scarv/scarv-soc/src/fsbl/README.md

# First Stage Boot Loader

This is a *very* simple boot rom which will pull a program binary
from a UART port into memory before jumping to it.

## FSBL Assumptions

- That the FSBL runs out of a *read only* memory.

- That the core is set up such that the post-reset PC value points
  at the base address of the memory the FSBL occupies.

- The FSBL program starts at the base address of the memory it
  occupies.

- The FSBL is *position independent*.

## FSBL Procedure

1. Initially the core is in reset.

2. The core is taken out of reset, and the PC is set to the
   base address of the FSBL rom.

3. The FSBL runs, minimally configuring any on-core state as needed.
