scarv/scarv-soc/doc/tex/design-scarv-cpu.tex

The \SCARVCPU is a 5 stage pipelined implementation of the RISC-V
{\tt rv32I} instruction set.
It is extended with the {\bf M}ultiply and {\bf C}ompressed standard
extensions, and the XCrypto non-standard extension for secure and
efficient cryptography.
The source code and documentaiton
for the \SCARVCPU can be found on
GitHub\footnote{\url{https://github.com/scarv/scarv-cpu}}.
