scarv/scarv-soc/doc/scarvsoc.tex

\documentclass{scarv-report}

\usepackage{scarvsoc}

\title{SCARV-SoC\\Technical Report and User Guide}
\date{Version $1.0.0$ (\today)}
\author{Ben Marshall}
\affil{
Department of Computer Science, University of Bristol,\\
Merchant Venturers Building, Woodland Road,\\
Bristol, BS8 1UB, United Kingdom.\\
\url{{ben.marshall}@bristol.ac.uk}
}

\begin{document}

% =============================================================================

\MKPROLOGUE

% =============================================================================

\section{Introduction}
\label{sec:intro}

\import{./tex/}{intro.tex}

\section{Features}
\label{sec:features}

\import{./tex/}{features.tex}

\section{Project Organisation}
\label{sec:organisation}

\import{./tex/}{organisation.tex}

\section{SoC Design}
\label{sec:design}
\import{./tex/}{design-overview.tex}

\subsection{Memory Map}
\label{sec:design:memory-map}
\import{./tex/}{design-memory-map.tex}

\subsection{SCARV-CPU}
\import{./tex/}{design-scarv-cpu.tex}

\subsection{Local Interconnect}
\label{sec:design:block:local-ic}
\import{./tex/}{design-local-ic.tex}

\subsection{Local Memories}
\import{./tex/}{design-local-mem.tex}

\subsection{AXI Bus Bridge}
\label{sec:design:axi-bridge}
\import{./tex/}{design-axi-bridge.tex}

\subsection{Xilinx Peripherals}
\import{./tex/}{design-xilinx.tex}

\section{Hardware Development Flows}
\label{sec:hw-flows}

\subsection{Getting Started}
\label{sec:flow:getting-started}
\import{./tex/}{flow-getting-started.tex}

\subsection{Make Flow Overview}
\import{./tex/}{flow-make.tex}

\subsection{Verilator Simulation}
\label{sec:flow:verilator}
\import{./tex/}{flow-verilator.tex}

\subsection{Symbiyosys Formal Verification Flow}
\import{./tex/}{flow-symbiyosys.tex}

\subsection{Yosys Synthesis}
\import{./tex/}{flow-yosys-synth.tex}

\subsection{Xilinx Vivado Project}
\import{./tex/}{flow-xilinx-vivado.tex}

\section{Software Development Guide}
\label{sec:sw-development}

\subsection{Selfchecking Tests}
\import{./tex/}{sw-selfcheck.tex}

\subsection{First Stage Boot Loader}
\label{sec:sw:fsbl}
\import{./tex/}{sw-fsbl.tex}

\subsection{Board Support Package}
\label{sec:sw:bsp}
\import{./tex/}{sw-bsp.tex}

\subsection{Example Programs}
\import{./tex/}{sw-examples.tex}

\subsection{Developing Programs}
\import{./tex/}{sw-development.tex}

\section{Acknowledgements}

This work has been supported in part by EPSRC via grant EP/R012288/1,
under the RISE (\url{http://www.ukrise.org}) programme.

% =============================================================================

\MKEPILOGUE

% =============================================================================

\end{document}
