scarv/scarv-soc/doc/image/soc-block-diagram.png

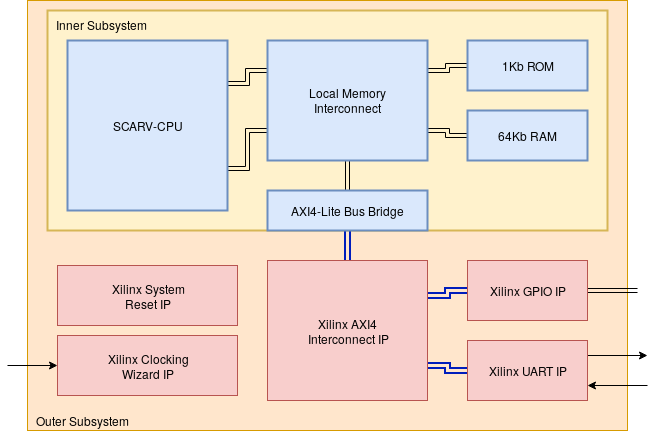
doc/image/soc-block-diagram.png
