scarv/scarv-soc/(threads)

Thread 7 (2019-10-22):

Self Checking Tests

ben-marshall, 2019-10-22:
A small set of sanity/smoke tests for checking things are still working.

Infrastructure:
- [X] Pass/Fail detection

Tests:
- [X] Simple code execution.
- [X] ~~RAM/ROM mixed instruction access.~~
- [x] RAM/ROM mixed data access.
- [x] Data bus error exception handler.
- [x] Instruction bus error exception handler.
- [x] Random number interface.
- [x] External interrupt handler.

Closed 2020-04-14.
