scarv/scarv-soc/rtl/ic/ic_top.v

//
// module: ic_top
//
//  Top level of the simple memory interconnect.
//
module ic_top (

input  wire        g_clk            ,
input  wire        g_resetn         ,

input  wire        cpu_imem_req     , // Start memory request
input  wire        cpu_imem_wen     , // Write enable
input  wire [ 3:0] cpu_imem_strb    , // Write strobe
input  wire [31:0] cpu_imem_wdata   , // Write data
input  wire [31:0] cpu_imem_addr    , // Read/Write address
output wire        cpu_imem_gnt     , // request accepted
output wire        cpu_imem_recv    , // Instruction memory recieve response.
input  wire        cpu_imem_ack     , // Instruction memory ack response.
output wire        cpu_imem_error   , // Error
output wire [31:0] cpu_imem_rdata   , // Read data

input  wire        cpu_dmem_req     , // Start memory request
input  wire        cpu_dmem_wen     , // Write enable
input  wire [ 3:0] cpu_dmem_strb    , // Write strobe
input  wire [31:0] cpu_dmem_wdata   , // Write data
input  wire [31:0] cpu_dmem_addr    , // Read/Write address
output wire        cpu_dmem_gnt     , // request accepted
output wire        cpu_dmem_recv    , // Data memory recieve response.
input  wire        cpu_dmem_ack     , // Data memory ack response.
output wire        cpu_dmem_error   , // Error
output wire [31:0] cpu_dmem_rdata   , // Read data

output wire        rom_imem_req     , // Start memory request
output wire        rom_imem_wen     , // Write enable
output wire [ 3:0] rom_imem_strb    , // Write strobe
output wire [31:0] rom_imem_wdata   , // Write data
output wire [31:0] rom_imem_addr    , // Read/Write address
input  wire        rom_imem_gnt     , // request accepted
input  wire        rom_imem_recv    , // Instruction memory recieve response.
output wire        rom_imem_ack     , // Instruction memory ack response.
input  wire        rom_imem_error   , // Error
input  wire [31:0] rom_imem_rdata   , // Read data

output wire        ram_imem_req     , // Start memory request
output wire        ram_imem_wen     , // Write enable
output wire [ 3:0] ram_imem_strb    , // Write strobe
output wire [31:0] ram_imem_wdata   , // Write data
output wire [31:0] ram_imem_addr    , // Read/Write address
input  wire        ram_imem_gnt     , // request accepted
input  wire        ram_imem_recv    , // Instruction memory recieve response.
output wire        ram_imem_ack     , // Instruction memory ack response.
input  wire        ram_imem_error   , // Error
input  wire [31:0] ram_imem_rdata   , // Read data

output wire        rom_dmem_req     , // Start memory request
output wire        rom_dmem_wen     , // Write enable
output wire [ 3:0] rom_dmem_strb    , // Write strobe
output wire [31:0] rom_dmem_wdata   , // Write data
output wire [31:0] rom_dmem_addr    , // Read/Write address
input  wire        rom_dmem_gnt     , // request accepted
input  wire        rom_dmem_recv    , // Instruction memory recieve response.
output wire        rom_dmem_ack     , // Instruction memory ack response.
input  wire        rom_dmem_error   , // Error
input  wire [31:0] rom_dmem_rdata   , // Read data

output wire        ram_dmem_req     , // Start memory request
output wire        ram_dmem_wen     , // Write enable
output wire [ 3:0] ram_dmem_strb    , // Write strobe
output wire [31:0] ram_dmem_wdata   , // Write data
output wire [31:0] ram_dmem_addr    , // Read/Write address
input  wire        ram_dmem_gnt     , // request accepted
input  wire        ram_dmem_recv    , // Instruction memory recieve response.
output wire        ram_dmem_ack     , // Instruction memory ack response.
input  wire        ram_dmem_error   , // Error
input  wire [31:0] ram_dmem_rdata   , // Read data

output wire        m0_awvalid       , //
input  wire        m0_awready       , //
output wire [31:0] m0_awaddr        , //
output wire [ 2:0] m0_awprot        , //
                                    
output wire        m0_wvalid        , //
input  wire        m0_wready        , //
output wire [31:0] m0_wdata         , //
output wire [ 3:0] m0_wstrb         , //
                                    
input  wire        m0_bvalid        , //
output wire        m0_bready        , //
input  wire [ 1:0] m0_bresp         , //
                                    
output wire        m0_arvalid       , //
input  wire        m0_arready       , //
output wire [31:0] m0_araddr        , //
output wire [ 2:0] m0_arprot        , //
                                    
input  wire        m0_rvalid        , //
output wire        m0_rready        , //
input  wire [ 1:0] m0_rresp         , //
input  wire [31:0] m0_rdata           //

);

//
// Memory map parameters.
// ------------------------------------------------------------

parameter MAP_ROM_MATCH = 32'h1000_0000;
parameter MAP_ROM_MASK  = 32'hFFFF_C000;
parameter MAP_ROM_RANGE = 32'h0000_03FF;

parameter MAP_RAM_MATCH = 32'h2000_0000;
parameter MAP_RAM_MASK  = 32'hFFFF_0000;
parameter MAP_RAM_RANGE = 32'h0000_FFFF;

parameter MAP_AXI_MATCH = 32'h4000_0000;
parameter MAP_AXI_MASK  = 32'hF000_0000;
parameter MAP_AXI_RANGE = 32'h0FFF_FFFF;

//
// Feature Parameters
// ------------------------------------------------------------

// Turn the AXI bridge on (1) or off (0).
parameter ENABLE_AXI_BRIDGE = 1;

//
// Input request address decoding.
// ------------------------------------------------------------

wire ic_imem_error    ; // Address decode error - doesn't map
wire ic_imem_route_rom; // Route to the ROM
wire ic_imem_route_ram; // Route to the RAM
wire ic_imem_route_axi; // Route to the AXI bridge.

wire ic_dmem_error    ; // Address decode error - doesn't map
wire ic_dmem_route_rom; // Route to the ROM
wire ic_dmem_route_ram; // Route to the RAM
wire ic_dmem_route_axi; // Route to the AXI bridge.

//
// Instruction <-> RAM Routing
// ------------------------------------------------------------

assign ram_imem_req   = ic_imem_route_ram && cpu_imem_req;

assign ram_imem_wen   = cpu_imem_wen  ; // Write enable
assign ram_imem_strb  = cpu_imem_strb ; // Write strobe
assign ram_imem_wdata = cpu_imem_wdata; // Write data
assign ram_imem_addr  = cpu_imem_addr ; // Read/Write address

assign ram_imem_ack   = imem_rsp_mask_ram && cpu_imem_ack;

//
// Instruction <-> Error Response
// ------------------------------------------------------------

wire        err_imem_req    = ic_imem_error && cpu_imem_req;

wire        err_imem_gnt    ;
wire        err_imem_recv   ;
wire        err_imem_ack    = imem_rsp_mask_err && cpu_imem_ack;
wire        err_imem_error  ;
wire [31:0] err_imem_rdata  ;

ic_error_rsp_stub i_error_stub_imem (
.g_clk      (g_clk          ),
.g_resetn   (g_resetn       ),
.enable     (err_imem_req   ), // Enable requests / does addr map?
.mem_req    (err_imem_req   ), // Start memory request
.mem_gnt    (err_imem_gnt   ), // request accepted
.mem_wen    ( 1'b0          ), // Write enable
.mem_strb   ( 4'b0          ), // Write strobe
.mem_wdata  (32'b0          ), // Write data
.mem_addr   (32'b0          ), // Read/Write address
.mem_recv   (err_imem_recv  ), // Instruction memory recieve response.
.mem_ack    (err_imem_ack   ), // Instruction memory ack response.
.mem_error  (err_imem_error ), // Error
.mem_rdata  (err_imem_rdata )  // Read data
);

//
// Instruction <-> ROM Routing
// ------------------------------------------------------------

assign rom_imem_req   = ic_imem_route_rom && cpu_imem_req;

assign rom_imem_wen   = cpu_imem_wen  ; // Write enable
assign rom_imem_strb  = cpu_imem_strb ; // Write strobe
assign rom_imem_wdata = cpu_imem_wdata; // Write data
assign rom_imem_addr  = cpu_imem_addr ; // Read/Write address

assign rom_imem_ack   = imem_rsp_mask_rom && cpu_imem_ack;


//
// Data <-> RAM Routing
// ------------------------------------------------------------

assign ram_dmem_req   = ic_dmem_route_ram && cpu_dmem_req;

assign ram_dmem_wen   = cpu_dmem_wen  ; // Write enable
assign ram_dmem_strb  = cpu_dmem_strb ; // Write strobe
assign ram_dmem_wdata = cpu_dmem_wdata; // Write data
assign ram_dmem_addr  = cpu_dmem_addr ; // Read/Write address

assign ram_dmem_ack   = dmem_rsp_mask_ram && cpu_dmem_ack;

//
// Data <-> ROM Routing
// ------------------------------------------------------------

assign rom_dmem_req   = ic_dmem_route_rom && cpu_dmem_req;

assign rom_dmem_wen   = cpu_dmem_wen  ; // Write enable
assign rom_dmem_strb  = cpu_dmem_strb ; // Write strobe
assign rom_dmem_wdata = cpu_dmem_wdata; // Write data
assign rom_dmem_addr  = cpu_dmem_addr ; // Read/Write address

assign rom_dmem_ack   = dmem_rsp_mask_rom && cpu_dmem_ack;

//
// Data <-> AXI
// ------------------------------------------------------------

wire        axi_dmem_req    = ic_dmem_route_axi && cpu_dmem_req;

wire        axi_dmem_gnt    ;
wire        axi_dmem_recv   ;
wire        axi_dmem_ack    = dmem_rsp_mask_axi && cpu_dmem_ack;
wire        axi_dmem_error  ;
wire [31:0] axi_dmem_rdata  ;

generate if(ENABLE_AXI_BRIDGE) begin // ENABLE_AXI_BRIDGE = 1

ic_cpu_bus_axi_bridge i_cpu_dmem_axi_bridge (
.m0_aclk         (g_clk           ), // AXI Clock
.m0_aresetn      (g_resetn        ), // AXI Reset
.m0_awvalid      (m0_awvalid      ), //
.m0_awready      (m0_awready      ), //
.m0_awaddr       (m0_awaddr       ), //
.m0_awprot       (m0_awprot       ), //
.m0_wvalid       (m0_wvalid       ), //
.m0_wready       (m0_wready       ), //
.m0_wdata        (m0_wdata        ), //
.m0_wstrb        (m0_wstrb        ), //
.m0_bvalid       (m0_bvalid       ), //
.m0_bready       (m0_bready       ), //
.m0_bresp        (m0_bresp        ), //
.m0_arvalid      (m0_arvalid      ), //
.m0_arready      (m0_arready      ), //
.m0_araddr       (m0_araddr       ), //
.m0_arprot       (m0_arprot       ), //
.m0_rvalid       (m0_rvalid       ), //
.m0_rready       (m0_rready       ), //
.m0_rresp        (m0_rresp        ), //
.m0_rdata        (m0_rdata        ), //
.enable          (axi_dmem_req    ), // Enable requests / does addr map?
.mem_req         (axi_dmem_req    ), // Start memory request
.mem_gnt         (axi_dmem_gnt    ), // request accepted
.mem_wen         (cpu_dmem_wen    ), // Write enable
.mem_strb        (cpu_dmem_strb   ), // Write strobe
.mem_wdata       (cpu_dmem_wdata  ), // Write data
.mem_addr        (cpu_dmem_addr   ), // Read/Write address
.mem_recv        (axi_dmem_recv   ), // Instruction memory recieve response.
.mem_ack         (axi_dmem_ack    ), // Instruction memory ack response.
.mem_error       (axi_dmem_error  ), // Error
.mem_rdata       (axi_dmem_rdata  )  // Read data
);

end else begin                       // ENABLE_AXI_BRIDGE = 0

// Tie all unused AXI signals to zero.
assign m0_awvalid = 0; //
assign m0_awaddr  = 0; //
assign m0_awprot  = 0; //
assign m0_wvalid  = 0; //
assign m0_wdata   = 0; //
assign m0_wstrb   = 0; //
assign m0_bready  = 0; //
assign m0_arvalid = 0; //
assign m0_araddr  = 0; //
assign m0_arprot  = 0; //
assign m0_rready  = 0; //

ic_error_rsp_stub i_error_stub_axi (
.g_clk      (g_clk          ),
.g_resetn   (g_resetn       ),
.enable     (axi_dmem_req   ), // Enable requests / does addr map?
.mem_req    (axi_dmem_req   ), // Start memory request
.mem_gnt    (axi_dmem_gnt   ), // request accepted
.mem_wen    ( 1'b0          ), // Write enable
.mem_strb   ( 4'b0          ), // Write strobe
.mem_wdata  (32'b0          ), // Write data
.mem_addr   (32'b0          ), // Read/Write address
.mem_recv   (axi_dmem_recv  ), // Instruction memory recieve response.
.mem_ack    (axi_dmem_ack   ), // Instruction memory ack response.
.mem_error  (axi_dmem_error ), // Error
.mem_rdata  (axi_dmem_rdata )  // Read data
);

end endgenerate

//
// Data <-> Error Response
// ------------------------------------------------------------

wire        err_dmem_req    = ic_dmem_error && cpu_dmem_req;

wire        err_dmem_gnt    ;
wire        err_dmem_recv   ;
wire        err_dmem_ack    = dmem_rsp_mask_err && cpu_dmem_ack;
wire        err_dmem_error  ;
wire [31:0] err_dmem_rdata  ;

ic_error_rsp_stub i_error_stub_dmem (
.g_clk      (g_clk          ),
.g_resetn   (g_resetn       ),
.enable     (err_dmem_req   ), // Enable requests / does addr map?
.mem_req    (err_dmem_req   ), // Start memory request
.mem_gnt    (err_dmem_gnt   ), // request accepted
.mem_wen    ( 1'b0          ), // Write enable
.mem_strb   ( 4'b0          ), // Write strobe
.mem_wdata  (32'b0          ), // Write data
.mem_addr   (32'b0          ), // Read/Write address
.mem_recv   (err_dmem_recv  ), // Instruction memory recieve response.
.mem_ack    (err_dmem_ack   ), // Instruction memory ack response.
.mem_error  (err_dmem_error ), // Error
.mem_rdata  (err_dmem_rdata )  // Read data
);

//
// Instruction Response Routing
// ------------------------------------------------------------

assign cpu_imem_recv =
    imem_rsp_mask_rom && rom_imem_recv    ||
    imem_rsp_mask_ram && ram_imem_recv    ||
    imem_rsp_mask_err && err_imem_recv    ;

assign cpu_imem_error=
    imem_rsp_mask_rom && rom_imem_error   ||
    imem_rsp_mask_ram && ram_imem_error   ||
    imem_rsp_mask_err && err_imem_error   ;

assign cpu_imem_rdata=
    {32{imem_rsp_mask_rom}} & rom_imem_rdata   |
    {32{imem_rsp_mask_ram}} & ram_imem_rdata   ;

assign cpu_imem_gnt   = imem_req_ready && (
    ic_imem_route_ram && ram_imem_gnt ||
    ic_imem_route_rom && rom_imem_gnt ||
    ic_imem_error     && err_imem_gnt );

wire [2:0] imem_reqs = {
    rom_imem_req && rom_imem_gnt,
    ram_imem_req && ram_imem_gnt,
    err_imem_req && err_imem_gnt
};

wire [2:0] imem_rsps = {
    rom_imem_recv && cpu_imem_ack,
    ram_imem_recv && cpu_imem_ack,
    err_imem_recv && cpu_imem_ack
};

wire [2:0] imem_rsp_mask;
wire       imem_rsp_mask_rom = imem_rsp_mask[2];
wire       imem_rsp_mask_ram = imem_rsp_mask[1];
wire       imem_rsp_mask_err = imem_rsp_mask[0];
wire       imem_req_ready;

ic_rsp_tracker #(
.ND (3),
.MAX_REQUESTS(3)
) i_ic_rsp_tracker_imem (
.g_clk          (g_clk         ),
.g_resetn       (g_resetn      ),
.requests       (imem_reqs     ),
.responses      (imem_rsps     ),
.response_gnt   (imem_rsp_mask ),
.ready          (imem_req_ready)
);

//
// Data Response Routing
// ------------------------------------------------------------

assign cpu_dmem_recv =
    dmem_rsp_mask_rom  && rom_dmem_recv    ||
    dmem_rsp_mask_ram  && ram_dmem_recv    ||
    dmem_rsp_mask_axi  && axi_dmem_recv    ||
    dmem_rsp_mask_err  && err_dmem_recv    ;

assign cpu_dmem_error=
    dmem_rsp_mask_rom  && rom_dmem_error   ||
    dmem_rsp_mask_ram  && ram_dmem_error   ||
    dmem_rsp_mask_axi  && axi_dmem_error   ||
    dmem_rsp_mask_err  && err_dmem_error   ;

assign cpu_dmem_rdata=
    {32{dmem_rsp_mask_rom}} & rom_dmem_rdata   |
    {32{dmem_rsp_mask_axi}} & axi_dmem_rdata   |
    {32{dmem_rsp_mask_ram}} & ram_dmem_rdata   ;

assign cpu_dmem_gnt   = dmem_req_ready && (
    ic_dmem_route_ram && ram_dmem_gnt ||
    ic_dmem_route_rom && rom_dmem_gnt ||
    ic_dmem_route_axi && axi_dmem_gnt ||
    ic_dmem_error     && err_dmem_gnt );

wire [3:0] dmem_reqs = {
    rom_dmem_req && rom_dmem_gnt,
    ram_dmem_req && ram_dmem_gnt,
    axi_dmem_req && axi_dmem_gnt,
    err_dmem_req && err_dmem_gnt
};

wire [3:0] dmem_rsps = {
    rom_dmem_recv && cpu_dmem_ack,
    ram_dmem_recv && cpu_dmem_ack,
    axi_dmem_recv && cpu_dmem_ack,
    err_dmem_recv && cpu_dmem_ack
};

wire [3:0] dmem_rsp_mask;
wire       dmem_rsp_mask_rom = dmem_rsp_mask[3];
wire       dmem_rsp_mask_ram = dmem_rsp_mask[2];
wire       dmem_rsp_mask_axi = dmem_rsp_mask[1];
wire       dmem_rsp_mask_err = dmem_rsp_mask[0];
wire       dmem_req_ready;

ic_rsp_tracker #(
.ND (4),
.MAX_REQUESTS(3)
) i_ic_rsp_tracker_dmem (
.g_clk          (g_clk         ),
.g_resetn       (g_resetn      ),
.requests       (dmem_reqs     ),
.responses      (dmem_rsps     ),
.response_gnt   (dmem_rsp_mask ),
.ready          (dmem_req_ready)
);

//
// Submodule instances
// ------------------------------------------------------------

// CPU Instruction memory interface address routing.
ic_addr_decode #(
.MAP_ROM_MATCH(MAP_ROM_MATCH),
.MAP_ROM_MASK (MAP_ROM_MASK ),
.MAP_ROM_RANGE(MAP_ROM_RANGE),
.MAP_RAM_MATCH(MAP_RAM_MATCH),
.MAP_RAM_MASK (MAP_RAM_MASK ),
.MAP_RAM_RANGE(MAP_RAM_RANGE),
.MAP_AXI_MATCH(MAP_AXI_MATCH),
.MAP_AXI_MASK (MAP_AXI_MASK ),
.MAP_AXI_RANGE(MAP_AXI_RANGE) 
) ic_addr_decode_cpu_imem (
.g_clk        (g_clk            ),   // Global clock
.g_resetn     (g_resetn         ),   // Synchronous active low reset
.req_valid    (cpu_imem_req     ),   // Request is valid
.req_addr     (cpu_imem_addr    ),   // Request address
.req_dec_err  (ic_imem_error    ),   // Address decode error - doesn't map
.route_rom    (ic_imem_route_rom),   // Route to the ROM
.route_ram    (ic_imem_route_ram),   // Route to the RAM
.route_axi    (ic_imem_route_axi)    // Route to the AXI bridge.
);

// CPU Data memory interface address routing.
ic_addr_decode #(
.MAP_ROM_MATCH(MAP_ROM_MATCH),
.MAP_ROM_MASK (MAP_ROM_MASK ),
.MAP_ROM_RANGE(MAP_ROM_RANGE),
.MAP_RAM_MATCH(MAP_RAM_MATCH),
.MAP_RAM_MASK (MAP_RAM_MASK ),
.MAP_RAM_RANGE(MAP_RAM_RANGE),
.MAP_AXI_MATCH(MAP_AXI_MATCH),
.MAP_AXI_MASK (MAP_AXI_MASK ),
.MAP_AXI_RANGE(MAP_AXI_RANGE) 
) ic_addr_decode_cpu_dmem (
.g_clk        (g_clk            ),   // Global clock
.g_resetn     (g_resetn         ),   // Synchronous active low reset
.req_valid    (cpu_dmem_req     ),   // Request is valid
.req_addr     (cpu_dmem_addr    ),   // Request address
.req_dec_err  (ic_dmem_error    ),   // Address decode error - doesn't map
.route_rom    (ic_dmem_route_rom),   // Route to the ROM
.route_ram    (ic_dmem_route_ram),   // Route to the RAM
.route_axi    (ic_dmem_route_axi)    // Route to the AXI bridge.
);

`ifdef FORMAL_IC_TOP

initial assume(!g_resetn);

always @(posedge g_clk) if(g_resetn && $past(g_resetn)) begin

    assert(!(imem_rsp_mask_err && imem_rsp_mask_rom));

    assert(!(imem_rsp_mask_err && imem_rsp_mask_ram));

    assert(!(imem_rsp_mask_ram && imem_rsp_mask_rom));

    assert(!(dmem_rsp_mask_err && dmem_rsp_mask_rom));

    assert(!(dmem_rsp_mask_err && dmem_rsp_mask_ram));

    assert(!(dmem_rsp_mask_ram && dmem_rsp_mask_rom));
    
    assert(!(dmem_rsp_mask_ram && dmem_rsp_mask_axi));
    
    assert(!(dmem_rsp_mask_err && dmem_rsp_mask_axi));
    
    assert(!(dmem_rsp_mask_rom && dmem_rsp_mask_axi));


    if($past(cpu_imem_recv) && !$past(cpu_imem_ack)) begin
        assert($stable(cpu_imem_recv ));
        assert($stable(cpu_imem_rdata));
        assert($stable(cpu_imem_error));
    end

    if($past(cpu_dmem_recv) && !$past(cpu_dmem_ack)) begin
        assert($stable(cpu_dmem_recv ));
        assert($stable(cpu_dmem_rdata));
        assert($stable(cpu_dmem_error));
    end

end

`endif

endmodule
