scarv/scarv-soc/verif/scarv-soc/memory_bus/memory_device_uart.hpp

#include <cstdlib>
#include <cassert>
#include <cstdio>

#include <iostream>
#include <queue>

#include <unistd.h>
#include <fcntl.h>

#include "memory_device.hpp"

#ifndef MEMORY_DEVICE_UART_HPP
#define MEMORY_DEVICE_UART_HPP

#define MEMORY_DEVICE_UART_RANGE 0x10

/*!
@brief A basic UART device for printing things during simulation.
@details:
Register Map:
Offset  |  Register
--------|----------------------
0x0     | RX
0x4     | TX
0x8     | STATUS
0xC     | CTRL
*/
class memory_device_uart : public memory_device {

public:
    
    memory_device_uart (
        memory_address base
    ) : memory_device(base,MEMORY_DEVICE_UART_RANGE) {

        addr_rx     = addr_base + 0 ;
        addr_tx     = addr_base + 4 ;
        addr_status = addr_base + 8 ;
        addr_ctrl   = addr_base + 12;

        this -> setup_pseudo_terminal();

    }

    ~memory_device_uart(){

        std::cout<<"Closing pseudo terminal"<<std::endl;
        close(pseudo_term_handle);

    }

    /*!
    @brief Read a word from the address given.
    @returns true if the read succeeds. False otherwise.
    */
    bool read_word (
        memory_address addr,
        uint32_t     * dout
    );

    /*!
    @brief Write a single byte to the device.
    @return true if the write is in range, else false.
    */
    bool write_byte (
        memory_address addr,
        uint8_t        data
    );


    /*!
    @brief Return a single byte from the device.
    */
    uint8_t read_byte (
        memory_address addr
    );
    
    int tx_buf_depth  = 16;

protected:
    
    //! Used to provide a virtual serial port.
    int pseudo_term_handle;
    
    //! Did the pseudo terminal open successfully?
    bool pseudo_term_open = false;
    
    //! Name of the slave pseudo terminal.
    char * pseudo_term_slave;
    
    //! Initialises the pseudo terminal.
    void setup_pseudo_terminal();
    
    //! Read any data from the pseudo terminal.
    void poll_pseudo_terminal();

    // Addresses of each register, calculated at instantiation.
    memory_address addr_tx;
    memory_address addr_rx;
    memory_address addr_ctrl;
    memory_address addr_status;
    
    // Contents of each register.
    uint32_t reg_tx;
    uint32_t reg_rx;
    uint32_t reg_ctrl;
    uint32_t reg_status;
    
    //! Stores characters to be read from this device via the TX register.
    std::queue<uint8_t> rx_buffer;

    //! Stores the data to be transmitted in a buffer until a newline is seen.
    std::queue<uint8_t> tx_buffer;

    //! Get the next char from the rx buffer and pop it from the buffer.
    uint8_t get_from_rx_buffer();

    //! Get the next char from the rx buffer and pop it from the buffer.
    void write_to_tx_buffer(uint8_t data);

};

#endif
