scarv/scarv-soc/(commit log)

2019-10-17 Add scarv-cpu submodule
    On branch master
    Your branch is up-to-date with 'origin/master'.
    Changes to be committed:
    new file: .gitmodules
    new file: extern/scarv-cpu
    Changes not staged for commit:
    modified: bin/conf.sh
    modified: doc/soc-design.md
    Untracked files:
    Makefile
    doc/memory-interconnect.md
    flow/
    rtl/
    verif/
    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
2019-10-17 Fix up project workspace script
    Your branch is ahead of 'origin/master' by 1 commit.
    (use "git push" to publish your local commits)
    work/
    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
2019-10-17 Started with very coarse top level RTL.
    Your branch is ahead of 'origin/master' by 3 commits.
    new file: rtl/ic/ic_addr_decode.v
    new file: rtl/ic/ic_cpu_bus_bram_bridge.v
    new file: rtl/ic/ic_cpu_bus_mux.v
    new file: rtl/ic/ic_top.v
    new file: rtl/soc/scarv_soc.v
    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
2019-10-17 Working verilator simulation flow.
    Your branch is ahead of 'origin/master' by 4 commits.
    new file: Makefile
    new file: flow/gtkwave/scarv-soc.gtkw
    new file: flow/verilator/Makefile.in
    new file: flow/verilator/scarv-soc-rtl.manifest
    new file: flow/verilator/scarv-soc-testbench.manifest
    new file: verif/scarv-soc/dut_wrapper.cpp
    new file: verif/scarv-soc/dut_wrapper.hpp
    new file: verif/scarv-soc/main.cpp
    new file: verif/scarv-soc/testbench.cpp
    new file: verif/scarv-soc/testbench.hpp
    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
2019-10-17 Add trimmed down FSBL.
    modified: Makefile
    new file: src/fsbl/Makefile.in
    new file: src/fsbl/README.md
    new file: src/fsbl/boot.S
    new file: src/fsbl/fsbl.c
    new file: src/fsbl/link.ld
    modified: flow/gtkwave/scarv-soc.gtkw
    modified: flow/verilator/Makefile.in
    modified: flow/verilator/scarv-soc-rtl.manifest
    modified: rtl/ic/ic_top.v
    modified: rtl/soc/scarv_soc.v
    rtl/mem/
    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
2019-10-17 Running code out of the ROM
    - Very basic bringup complete.
    - Todo:
    - Routing to RAM
    - Loading of memory into the RAM.
    - Fix awful fetch buffering of the SCARV CPU
    new file: rtl/mem/scarv_soc_bram_single.v
    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
    [ic_top.v, scarv_soc.v]
2019-10-17 Plumbed in instruction RAM.
    - Seems to work jumping from ROM to RAM.
    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
2019-10-17 Put IC response tracking inside own module.
    - makes logc reuse easier.
    new file: rtl/ic/ic_rsp_router.v
    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
2019-10-17 Simple assertions + option to blackbox BRAM read data.
    modified: rtl/ic/ic_addr_decode.v
    modified: rtl/mem/scarv_soc_bram_single.v
    flow/formal/
    verif/formal/
    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
2019-10-17 SymbiYosys files for running designer assertions.
    new file: flow/formal/Makefile.in
    new file: flow/formal/read_sources.tcl
    new file: verif/formal/ic_address_map.sby
    new file: verif/formal/ic_top.sby
    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
2019-10-17 Better proof make flow
2019-10-17 Fix proofs make flow
2019-10-18 Step 1 of integrating data memory interfaces
    modified: doc/memory-interconnect.md
    new file: rtl/mem/scarv_soc_bram_dual.v
    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
2019-10-18 Various tweaks / fixes
    - Fix range of ROM: Should have been 3FF not 3FFF
    - Lengthen default sim time.
    - Play with FSBL
    Your branch is ahead of 'origin/master' by 2 commits.
    modified: flow/formal/Makefile.in
    modified: src/fsbl/boot.S
    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
    [ic_top.v, scarv_soc.v]
2019-10-18 Better / more efficient instruction fetch.
    - Fix bug which caused accidental writes to BRAMs
    - Add request buffering in the CPU BUS/BRAM Bridge modules.
    modified: extern/scarv-cpu
    modified: flow/formal/read_sources.tcl
    modified: rtl/ic/ic_cpu_bus_bram_bridge.v
    modified: rtl/ic/ic_rsp_router.v
    modified: src/fsbl/Makefile.in
    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
    [ic_cpu_bus_bram_bridge.v, ic_top.v, scarv_soc.v]
2019-10-21 Fix cpu mem bus/bram bridge response stalling.
    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
    [ic_cpu_bus_bram_bridge.v]
2019-10-21 Final tweaks for CPU BRAM Bridge
    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
2019-10-21 Re-write CPU bus BRAM bridge module
    - Use FSM to control buffering and draining of stalled requests.
    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
    [ic_cpu_bus_bram_bridge.v]
2019-10-21 Fix missing state transition in BRAM Bus Bridge
    [ic_cpu_bus_bram_bridge.v]
2019-10-22 Change verilator / fsbl dependencies
    - verilator-run-* now depends on the fsbl target.
    - verilator-build does not depend on the fsbl target.
    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
2019-10-22 Add stub error response module for CPU data bus
    - See #9
    - Only added for data bus. Needs some self-checking tests to see if
    it works.
    new file: rtl/ic/ic_error_rsp_stub.v
    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
    [ic_error_rsp_stub.v, ic_top.v]
2019-10-22 Working on IC error response stubs.
    - Synchronous logic works best with a clock signal...
    modified: rtl/ic/ic_error_rsp_stub.v
    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
    [ic_error_rsp_stub.v, ic_top.v]
2019-10-22 Start work on selfchecking tests flow.
    - See #7
    - Can build dedicated bootloader and example test.
    - Need to add pass/fail mechanism to verilator flow.
    - Need to make swapping of memory hex files in/out.
    new file: flow/selfcheck/Makefile.in
    new file: flow/selfcheck/boot-link.ld
    new file: flow/selfcheck/test-link.ld
    new file: verif/selfcheck/bootloader/bootloader.S
    new file: verif/selfcheck/share/selfcheck.S
    new file: verif/selfcheck/share/selfcheck.h
    new file: verif/selfcheck/test_00_example/example.c
    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
2019-10-23 Top level parameters and verilator signal visibility.
    - Make RAM memory file parameter visible and usable.
    - Expose the CPU trace signal interface to verilated environment.
    modified: flow/selfcheck/Makefile.in
    modified: verif/scarv-soc/dut_wrapper.cpp
    modified: verif/scarv-soc/dut_wrapper.hpp
    modified: verif/scarv-soc/main.cpp
    modified: verif/scarv-soc/testbench.cpp
    modified: verif/scarv-soc/testbench.hpp
    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
2019-10-23 Changes to verilated environment
    - Unique verilated file generation for each default ram/rom image.
    - Slow but bullet proof solution.
    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
2019-10-23 Working example selfchecking test.
    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
2019-10-23 Some *very* simple tests for the SoC RAM/ROM
    new file: verif/selfcheck/test_01_simple/simple.c
    new file: verif/selfcheck/test_02_ram_rom_data/main.c
    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
2019-10-23 Add basic data bus error self checking test.
    new file: verif/selfcheck/test_03_data_bus_error/error.S
    new file: verif/selfcheck/test_03_data_bus_error/main.c
    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
    [main.c]
2019-10-23 Better memory map coverage for data bus error test
    [main.c]
2019-10-24 Add checks to data bus error selfcheck test.
    - Make sure that regions which should not produce an error
    don't produce an error.
    modified: verif/selfcheck/test_03_data_bus_error/error.S
    modified: verif/selfcheck/test_03_data_bus_error/main.c
    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
    [main.c]
2019-10-24 Fix ROM address range bug, as picked up by selfcheck test.
    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
    [ic_addr_decode.v]
2019-10-24 Split data error tests
    - Rename data bus error test to data load error
    - New test for data store errors
    renamed: verif/selfcheck/test_03_data_bus_error/error.S -> verif/selfcheck/test_03_data_load_error/error.S
    renamed: verif/selfcheck/test_03_data_bus_error/main.c -> verif/selfcheck/test_03_data_load_error/main.c
    new file: verif/selfcheck/test_04_data_store_error/error.S
    new file: verif/selfcheck/test_04_data_store_error/main.c
    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
    [main.c]
2019-10-24 Add RTL for instruction bus error responses.
    - Add error stub peripheral for instruction memory bus to
    the interconnect.
    modified: verif/selfcheck/test_03_data_load_error/error.S
    modified: verif/selfcheck/test_04_data_store_error/error.S
    verif/selfcheck/test_05_instr_bus_error/
    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
    [ic_top.v]
2019-10-24 Fix trap handlers for selfcheck tests 03/04
    - Make sure they fail gracefully and don't just timeout.
    modified: extern/scarv-cpu (new commits)
    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
2019-10-24 Add instruction bus error test.
    new file: verif/selfcheck/test_05_instr_bus_error/error.S
    new file: verif/selfcheck/test_05_instr_bus_error/main.c
    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
    [main.c]
2019-10-24 Verilator support for a dumb AXI4Lite slave agent.
    - Just responds with the right control flow signals.
    - Doesn't do anything with the data etc.
    modified: flow/verilator/scarv-soc-testbench.manifest
    new file: verif/scarv-soc/axi4lite/a4l_slave_agent.cpp
    new file: verif/scarv-soc/axi4lite/a4l_slave_agent.hpp
    new file: verif/scarv-soc/axi4lite/a4l_txns.hpp
    modified: rtl/ic/ic_cpu_bus_axi_bridge.v
    verif/se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
    [dut_wrapper.cpp, dut_wrapper.hpp]
2019-10-24 Simple test for AXI bus
    - Just hammers it with loads/stores to make sure we don't lock
    up the bus.
    new file: verif/selfcheck/test_06_axi_bridge/main.c
    new file: verif/selfcheck/test_06_axi_bridge/test.S
    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
2019-10-24 Bugfixes to the AXI bridge.
    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
    [ic_cpu_bus_axi_bridge.v]
2019-10-25 RTL and assertion fixes for AXI bus bridge
    modified: verif/formal/ic_cpu_bus_axi_bridge.sby
    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
    [ic_cpu_bus_axi_bridge.v]
2019-10-25 Integrate memory bus model to verilator environment.
    - Added small RAM model at base of AXI address range for
    self checking test.
    - Added UART model at 0x40001000
    Your branch is ahead of 'origin/master' by 5 commits.
    modified: verif/scarv-soc/axi4lite/a4l_slave_agent.cpp
    modified: verif/scarv-soc/axi4lite/a4l_slave_agent.hpp
    new file: verif/scarv-soc/memory_bus/memory_bus.cpp
    new file: verif/scarv-soc/memory_bus/memory_bus.hpp
    new file: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
2019-10-25 Sparse test for the modelled AXI UART.
    modified: verif/selfcheck/share/selfcheck.S
    modified: verif/selfcheck/share/selfcheck.h
    new file: verif/selfcheck/test_07_axi_uart/main.c
    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
2019-10-25 Proof fixes for CPU Bus AXI Bridge
    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
    [ic_cpu_bus_axi_bridge.v]
2019-10-25 Working virtual UART
    modified: verif/scarv-soc/memory_bus/memory_device_uart.cpp
    modified: verif/scarv-soc/memory_bus/memory_device_uart.hpp
    modified: verif/selfcheck/test_07_axi_uart/main.c
    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
2019-10-28 Remove interactivity from UART self-check test
2019-10-28 Actually remove interactivity from uart test
2019-10-28 Add beginnings of the BSP for the SCARV SoC
    - Only a simple UART driver for now.
    new file: src/bsp/Makefile.in
    new file: src/bsp/include/scarvsoc.h
    new file: src/bsp/include/scarvsoc_uart.h
    new file: src/bsp/src/scarvsoc_uart.c
    src/examples/
    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
2019-10-28 Add example application which echos UART data.
    new file: src/examples/Makefile.in
    new file: src/examples/share/link.ld
    new file: src/examples/uart/Makefile.in
    new file: src/examples/uart/example_uart.c
    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
2019-10-28 Fix UART model to use proper IO
    modified: src/bsp/include/scarvsoc_uart.h
    modified: src/bsp/src/scarvsoc_uart.c
    modified: src/examples/Makefile.in
    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
    [memory_device_uart.cpp, memory_device_uart.hpp]
2019-10-28 Make the FSBL sensible.
    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
2019-10-28 Fix UART Driver zero/non-zero conditions
    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
    [scarvsoc_uart.c, scarvsoc_uart.h]
2019-10-28 Make flow changes
    - Reorder top level includes to respect dependencies.
    - Change default verilator build to use whatever ram.hex / rom.hex file
    is present in the current working directory.
    - Fix how the example programs are run.
    Your branch is ahead of 'origin/master' by 6 commits.
    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
2019-10-28 Fix #8 - Expose interrupt pins.
    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
    [scarv_soc.v]
2019-10-28 Adding very simply Yosys synthesis flow.
    - Doesn't handle BRAMs
    - Fixes #12
    new file: flow/synthesis/Makefile.in
    new file: flow/synthesis/scarv-soc-rtl.tcl
    new file: flow/synthesis/synth_yosys.tcl
    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
2019-10-28 Fix IC error response stub multi-driven net.
    modified: flow/synthesis/scarv-soc-rtl.tcl
    deleted: rtl/mem/scarv_soc_bram_dual.v
    deleted: rtl/mem/scarv_soc_bram_single.v
    flow/xilinx/
    rtl/mem/scarv_soc_bram_dual_formal.v
    rtl/mem/scarv_soc_bram_dual_sim.v
    rtl/mem/scarv_soc_bram_dual_synth_xilinx_xc7k.v
    rtl/mem/scarv_soc_bram_dual_synth_yosys.v
    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
    [ic_error_rsp_stub.v]
2019-10-28 fsbl.mem -> fsbl.hex
    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
2019-10-28 Split BRAM modules into purposes.
    - One for Xilinx XC7K synthesis targets.
    - One for Yosys synthesis targets.
    - One for verilator simulation targets.
    - One for formal/BMC proofs. Blackboxed.
    new file: rtl/mem/scarv_soc_bram_dual_formal.v
    new file: rtl/mem/scarv_soc_bram_dual_sim.v
    new file: rtl/mem/scarv_soc_bram_dual_synth_xilinx_xc7k.v
    new file: rtl/mem/scarv_soc_bram_dual_synth_yosys.v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
2019-10-28 Xilinx XC7K pin constraints.
    new file: flow/xilinx/constraints-xc7k.xdc
    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
2019-10-28 Add top-level sim testbench to Xilinx flow
    new file: flow/xilinx/tb_top.v
    modified: rtl/mem/scarv_soc_bram_dual_synth_xilinx_xc7k.v
    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
2019-10-28 Fixes to the Xilinx BRAM model
    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
    [scarv_soc_bram_dual_synth_xilinx_xc7k.v]
2019-10-29 Add ability to pause simulation start
    - Waits for keypress before starting.
    - Gives devs the chance to connect a terminal to the pts.
    modified: flow/selfcheck/boot-link.ld
    modified: flow/selfcheck/test-link.ld
    modified: rtl/mem/scarv_soc_bram_dual_sim.v
    modified: src/examples/share/link.ld
    modified: src/fsbl/fsb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
2019-10-29 Add proper FSBL for downloading SW over UART
    modified: src/fsbl/fsbl.c
    modified: src/fsbl/link.ld
    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
2019-10-29 Put OBJCOPY args in toplevel makefile
    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
2019-10-29 Tighter linker scripts.
    - Add MEMORY to all linker scripts.
    - Top level OBJCOPY arguments added
    - Set .text section in selfcheck assembly.
    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
2019-10-29 Add really dumb GPIO peripheral.
    new file: verif/scarv-soc/memory_bus/memory_device_gpio.cpp
    new file: verif/scarv-soc/memory_bus/memory_device_gpio.hpp
    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
2019-10-29 Re-enable GPIO status indicators in FSBL.
    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
2019-10-29 UART Example: print welcome message
2019-10-29 Python script to upload programs via UART
    - Works for simulator or FPGA target.
    new file: bin/upload-program.py
    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
2019-10-30 Change Xilinx TB top to make sure reset works
    [tb_top.v]
2019-10-30 Re-write Xilinx bram module
    - Easier to work with init mem files.
    - Coppies their language template for BRAM inference.
    bin/vl-hex-align.py
    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
2019-10-30 Script to fix BRAM init files for Xilinx.
    new file: bin/vl-hex-align.py
    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
    [vl-hex-align.py]
2019-10-30 Add re-creatable Xilinx project
    new file: bin/create-xilinx-xc7k-project.sh
    new file: flow/xilinx/scarv-soc-project.tcl
    new file: flow/xilinx/tb_top_behav.wcfg
    new file: rtl/xilinx/system_top_wrapper.v
    renamed: flow/xilinx/tb_top.v -> verif/xilinx/tb_top.v
    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
2019-10-30 Add pre-generated bitfile and xilinx how-to
    modified: README.md
    new file: doc/xilinx-project.md
    new file: flow/xilinx/scarv-soc-xc7k.bit
    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
2019-10-30 Fix formal flow after memory renaming
    modified: rtl/mem/scarv_soc_bram_dual_formal.v
    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
    [scarv_soc_bram_dual_formal.v]
2019-10-30 Tentative fix for #14
    - Add new component to track responses and their orderings.
    - Mostly replaces the functionality found in ic_rsp_router
    - Future commit should remove ic_rsp_router.
    new file: rtl/ic/ic_rsp_tracker.v
    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
    [ic_rsp_tracker.v, ic_top.v]
2019-10-30 Xilinx project changes for changes relating to #14
    modified: flow/xilinx/scarv-soc-project.tcl
    modified: flow/xilinx/scarv-soc-xc7k.bit
    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
2019-10-31 Add simple LFSR RNG to RTL.
    - See #10
    - Added Top level RNG which allows switching between different RNG
    implementations at synthesis time.
    - Currently only the LFSR implementation is available.
    new file: rtl/rng/scarv_rng_lfsr.v
    new file: rtl/rng/scarv_rng_top.v
    verif/selfcheck/test_08_rng/
    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
2019-10-31 Simple selfcheck test for the random number interface.
    - Checks we can seed/sample/test without everything locking up.
    new file: verif/selfcheck/test_08_rng/main.c
    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
2019-10-31 Update bitfile with RNG integration.
    - Closes #10
    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
2019-10-31 Re-instate GPIO led FSBL progress
2019-10-31 Basic GPIO driver for the SoC BSP
    modified: src/bsp/Makefile.in
    modified: src/bsp/include/scarvsoc.h
    new file: src/bsp/include/scarvsoc_gpio.h
    new file: src/bsp/src/scarvsoc_gpio.c
    modified: src/examples/uart/example_uart.c
    flow/xilinx/Makefile.in
    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
2019-10-31 Use GPIOs in the UART example
2019-10-31 Add simple xilinx makefile for uploading programs.
    new file: flow/xilinx/Makefile.in
    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
2019-10-31 Add RNG files to Xilinx project tcl script.
    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
2019-10-31 Bump scarv-soc.
    - NMI Interrupt support.
    - External interrupt cause codes.
    - Updated bitfile
    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
2019-10-31 Skeleton files for technical report/documentation.
    - See #15
    modified: doc/scarvsoc.tex
    new file: doc/tex/design-axi-bridge.tex
    new file: doc/tex/design-local-ic.tex
    new file: doc/tex/design-local-mem.tex
    new file: doc/tex/design-scarv-cpu.tex
    new file: doc/tex/design-xilinx.tex
    new file: doc/tex/flow-bootloader.tex
    new file: doc/tex/flow-make.tex
    new file: doc/tex/flow-symbiyosys.tex
    new file: doc/tex/flow-verilator.tex
    new file: doc/tex/flow-xilinx-vivado.tex
    new file: doc/tex/flow-yosys-synth.tex
    new file: doc/tex/flow.tex
    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
2019-11-01 Copy rough design requirements.
    new file: doc/scarvsoc.sty
    deleted: doc/soc-requirements.md
    modified: doc/tex/requirements.tex
    modified: extern/texmf (untracked content)
    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
2019-11-01 docs: Intro
    modified: doc/scarvsoc.sty
    modified: doc/tex/intro.tex
    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
2019-11-01 doc: Filling out early smaller sections.
    deleted: doc/memory-interconnect.md
    modified: doc/tex/design-axi-bridge.tex
    modified: doc/tex/design-local-ic.tex
    modified: doc/tex/design-local-mem.tex
    new file: doc/tex/design-memory-map.tex
    new file: doc/tex/design-overview.tex
    modified: doc/tex/design-scarv-cpu.tex
    modified: doc/tex/design-xilinx.tex
    modified: doc/tex/organisation.tex
    modified: extern/texmf (untracked content)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
2019-11-01 docs: Hardware flow descriptions.
    modified: doc/tex/design-overview.tex
    new file: doc/tex/flow-getting-started.tex
    modified: doc/tex/flow-make.tex
    modified: doc/tex/flow-symbiyosys.tex
    modified: doc/tex/flow-verilator.tex
    modified: doc/tex/flow-yosys-synth.tex
    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
2019-11-01 Vivado flow
2019-11-04 doc: remove old xilinx project markdown docs
    - Content moved to doc/tex/flow-xilinx.tex
    deleted: doc/xilinx-project.md
    modified: doc/Makefile
    modified: doc/tex/design-memory-map.tex
    modified: doc/tex/features.tex
    modified: doc/tex/flow-getting-started.tex
    m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
2019-11-04 Add missing arguments to verilated -h
    modified: doc/tex/flow-verilato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
    [main.cpp]
2019-11-04 docs: lots of fixes, changes and additions.
    - Add verilator flow explanation.
    - Edit all design sections.
    - Edit intro/organisation sections.
    new file: doc/graphs/verilator-srcs.dot
    modified: doc/tex/flow-getting-star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
2019-11-04 docs: remove flow bootloader section. put everything in SWDG
2019-11-04 docs: split bootloader and add selfchecking flow.
    modified: doc/tex/sw-fsbl.tex
    new file: doc/tex/sw-selfcheck.tex
    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
2019-11-04 Explain FSBL operation.
    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
2019-11-05 docs: UART example
    modified: doc/tex/sw-examples.tex
    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
2019-11-05 Add project dependencies
    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
2019-11-05 Change Xilinx BRAM default mem file
    On branch dev/lattice
    flow/lattice/
    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
2019-11-05 Starting work on the lattice FPGA flow.
    new file: flow/lattice/Makefile.in
    new file: flow/lattice/constraints.pcf
    new file: flow/lattice/lattice.tcl
    new file: flow/lattice/scarv-soc-rtl.tcl
    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
2019-11-05 Bump scarv-cpu
    modified: flow/lattice/Makefile.in
    modified: flow/lattice/constraints.pcf
    modified: flow/lattice/lattice.tcl
    modified: flow/lattice/scarv-soc-rtl.tcl
    rtl/lattice/
    rtl/mem/scarv_soc_bram_dual_synth_lattice.v
    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
2019-11-05 Working on lattice flow. Synthesis working. PNR fails.
    - Yosys can now synthesise the SoC inner layer. It is 2.5x too big.
    - PNR fails due to lack of resources.
    - Dedicated lattice memory model. Only single ported so won't actually
    work yet.
    new file: rtl/lattice/lattice_top.v
    new file: rtl/mem/scarv_soc_bram_dual_synth_lattice.v
    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
    [lattice_top.v, scarv_soc.v, scarv_soc_bram_dual_synth_lattice.v]
2019-11-05 Make it possible to turn the AXI bridge on/off
    modified: rtl/lattice/lattice_top.v
    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
2019-11-05 Tweaks to the Lattice flow
    - Pin constraints
    - Specify package explicitly
    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
2019-11-06 Working on removing ic_rsp_router component.
    - See #16
    - RTL work mostly done.
    - Need to regenerate Xilinx bitfile and project tcl.
    - Need to redo formal assertions.
    On branch dev/issue-16
    deleted: rtl/ic/ic_rsp_router.v
    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
    [ic_top.v]
2019-11-07 Fix hissenbug due to GPIO function return.
    - Boolean function should have returned true or false.
    - Instead returned 0 or undefined.
    modified: verif/scarv-soc/memory_bus/memory_device_gpio.cpp
    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
    [memory_device_gpio.cpp]
2019-11-08 Remove extra semicolon
    Your branch is up-to-date with 'origin/dev/issue-16'.
    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
    [ic_top.v]
2019-11-08 Fix missing sources in synthesis manifest
    Your branch is ahead of 'origin/dev/issue-16' by 1 commit.
    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
2019-11-08 Remove reference to ic_rsp_router from docs.
    modified: rtl/ic/ic_rsp_tracker.v
    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
2019-11-08 Fix formal flow manifest
    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
2019-11-08 Update assertions for #16
    Your branch is ahead of 'origin/dev/issue-16' by 2 commits.
    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
    [ic_rsp_tracker.v, ic_top.v]
2019-11-08 File manifest for Xilinx project tcl for #16
    Your branch is ahead of 'origin/dev/issue-16' by 3 commits.
    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
2019-11-08 Update bitfile for #16
    Your branch is ahead of 'origin/dev/issue-16' by 4 commits.
    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
2019-12-05 Bump extern/scarv-cpu
    - Includes changes for FENL.
    - Re-generate bitfile.
    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
2020-02-20 Fix scarv-soc-rtl manifest file paths.
    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
2020-03-03 Bump scarv-cpu: Vectored interrupt support.
    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
2020-03-23 Bump extern/scarv-cpu After interrupt fixes
    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
2020-03-26 RTL: Add stub int_mtime wire to scarv_soc
    - Extra pin on scarv_cpu needs terminating or verilator complains.
    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
2020-04-08 formal: Fix read_source.tcl file paths
    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
2020-04-14 flow: Update GTKWave view
2020-04-14 flow: verilator - Always copy ram/rom images
    - When building the verilator image, always make sure that there
    are ram/rom images to load so it doesn't crash.
    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
2020-04-14 rtl: Fix how address ranges are computed in IC.
    - Changing the RAM_SIZE parameter in the scarv_soc top module now
    changes the address mappings all the way down to the interconnect
    level.
    - Before this fix, you could increase the ram size, butthe address decoders
    wouldn't be aware of the change, and would raise bus errors when trying
    to access the larger RAM addresses.
    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
    [ic_top.v, scarv_soc.v, scarv_soc_bram_dual_sim.v]
2020-04-27 General: make scarv cpu RTL dir and env var.
    - Also update docs
    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
2020-04-27 Flow: Re-use scarv cpu RTL manifest.
    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
2020-04-27 Flow: Update Xilinx flow and bitstream.
    - Update project generation script to take advantage of
    beter manifests.
    - Re-generate bitstream
    modified: flow/xilinx/tb_top_behav.wcfg
    renamed: rtl/xilinx/system_top_wrapper.v -> rtl/xilinx/system_top_wrapper_wrapper.v
    modified: verif/xilinx/tb_top.v
    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
2020-04-28 Flow: Fix missing verilator include path
    modified: flow/xilinx/Makefile.in
    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
2020-04-28 Flow: Print info when uploading to xilinx target
2020-04-28 Flow: Xilinx: Update project tcl
2020-04-28 Flow: Xilinx: Update bitfile
2020-05-05 Add useful goto command for upload-program.py
    On branch scarv/xcrypto/masking-ise
    modified: bin/upload-program.py
    modified: extern/scarv-cpu (modified content)
    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
2020-06-30 Misc updates to flows and docs.
    - Update bin/vl-hex-align.py script to avoid need for audacious use of sed.
    - Update Xilinx project TCL script to fix wave view loading.
    - Update bitfile.
    - Update BSP documentation generation using Doxygen to make sure destination
    directory exists.
    - Update documentation:
    - Add explanation of uploading programs to the FPGA.
    - Misc other notes.
    modified: bin/vl-hex-align.py
    modified: doc/tex/flow-xilinx-vivado.tex
    modified: flow/xilin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
    [vl-hex-align.py]
2020-06-30 docs: Update links in getting started.
    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
